fabXlabs/fabX_compactPCB/testAssemblyRender2.JPG

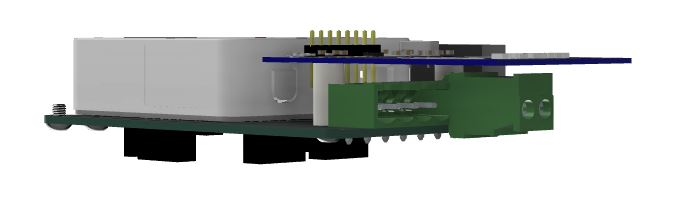
testAssemblyRender2.JPG
