fabXlabs/fabX_compactPCB/testAssemblyRender3.JPG

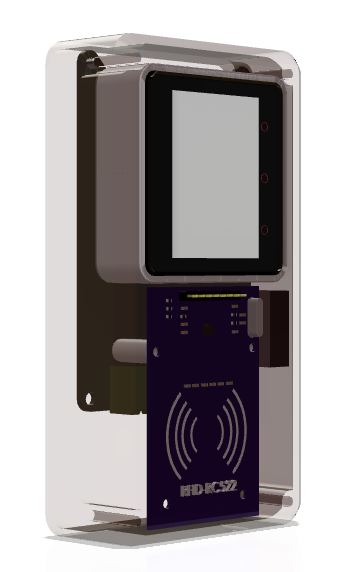
testAssemblyRender3.JPG
