fabXlabs/fabX_compactPCB/README.md

# fabX_compactPCB
Compact PCB (M5+CardReader+3xIO) for many simple Tasks
