fabXlabs/fabX_compactPCB/2022-10-31_bot2.JPG

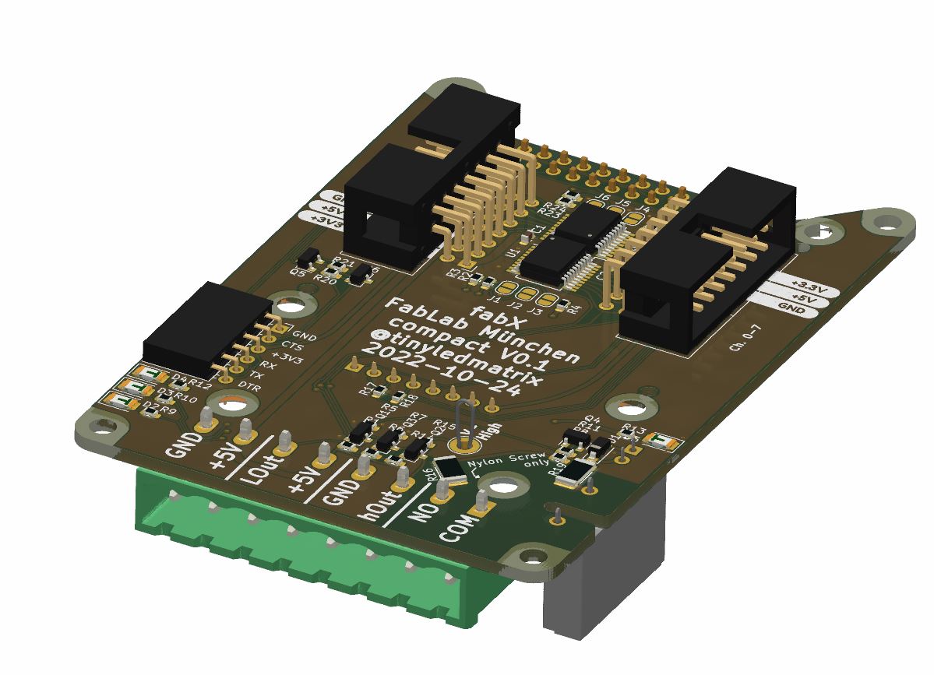
2022-10-31_bot2.JPG
