fabXlabs/fabX_compactPCB/2022-10-31_bot.JPG

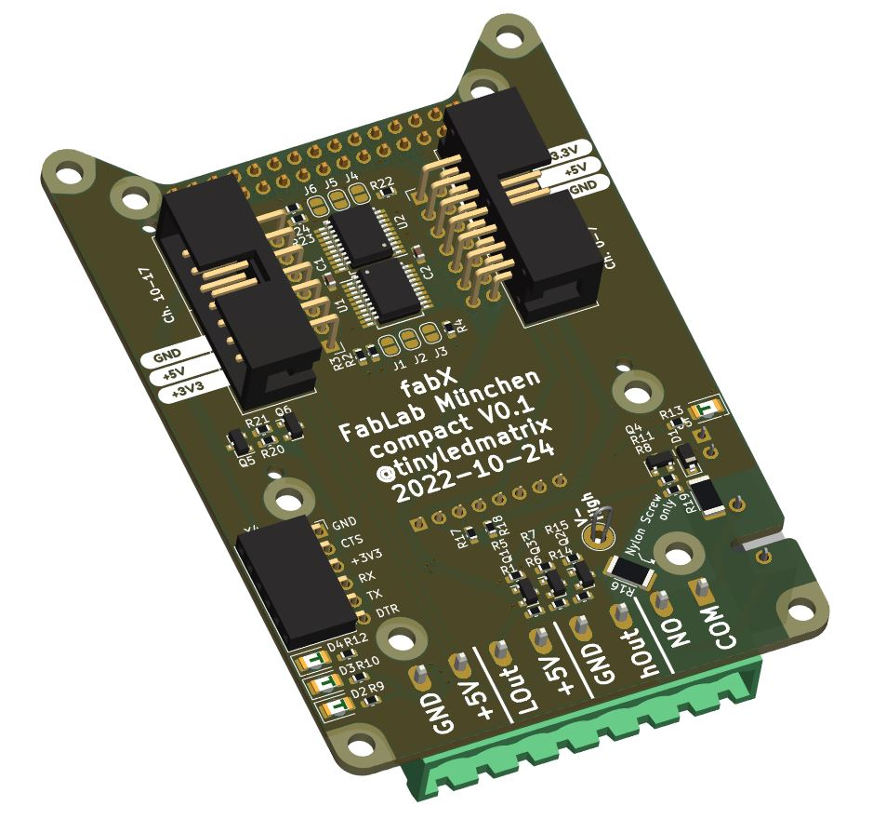
2022-10-31_bot.JPG
