fabXlabs/fabX_compactPCB/2022-10-31_top.JPG

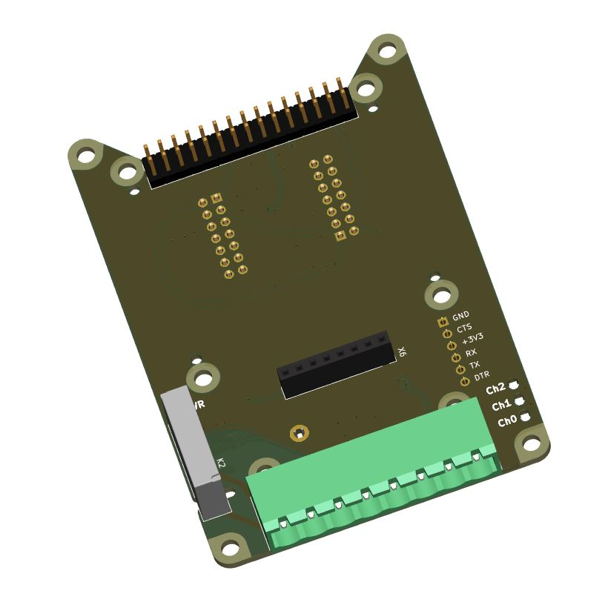
2022-10-31_top.JPG
