fabXlabs/fabX_compactPCB/KiCad_Project/BOM_fabX_cleaned.ods

Source: |  | D:\GitHub\fabX_compactPCB\KiCad_Project\fabX_compact.kicad_sch
Date: |  | 10/31/2022 6:27:46 PM
Tool: |  | Eeschema (6.0.6)
Generator: |  | C:\Program Files\KiCad\5.99\bin\scripting\plugins/bom_csv_grouped_by_value.py
Component Count: |  | 60
Individual Components:
Item | Qty | Reference(s) | Value | Footprint | Datasheet | Farnell# | Mnf | Mnf#
 |  | C1 | 100n 6v3 X7R | Capacitor_SMD:C_0603_1608Metric |  | 3345771 | Vishay | VJ0603Y104KXXPW1BC
 |  | C2 | 100n 6v3 X7R | Capacitor_SMD:C_0603_1608Metric |  | 3345771 | Vishay | VJ0603Y104KXXPW1BC
 |  | D1 | D | Diode_SMD:D_ | ~ | 2760409 | Nexperia | PMEG3020EGWX
 |  | D2 | LED | ownLEDs:LED_1206_3216Metric_ReverseMount_Hole1.8x2.4mm_3DMOD | ~ | 2099257 | Kingbright | KPTR-3216SYCK
 |  | D3 | LED | ownLEDs:LED_1206_3216Metric_ReverseMount_Hole1.8x2.4mm_3DMOD | ~ | 2099257 | Kingbright | KPTR-3216SYCK
 |  | D4 | LED | ownLEDs:LED_1206_3216Metric_ReverseMount_Hole1.8x2.4mm_3DMOD | ~ | 2099257 | Kingbright | KPTR-3216SYCK
 |  | D5 | LED | ownLEDs:LED_1206_3216Metric_ReverseMount_Hole1.8x2.4mm_3DMOD | ~ | 2099257 | Kingbright | KPTR-3216SYCK
 |  | K2 | PCN-105D3MHZ | Relay_THT:Relay_SPST_TE_PCN-1xxD3MHZ | https://standexelectronics.com/de/produkte/ums-reed-relais/ | 4444930 | TE | PCN-105D3MHZ
 |  | Q1 | 2N7002 | Package_TO_SOT_SMD:SOT-23 | https://www.onsemi.com/pdf/datasheet/nds7002a-d.pdf | 3924478 | Nexperia | 2N7002HR
 |  | Q2 | DMP3056L-7 | Package_TO_SOT_SMD:SOT-23 | https://www.farnell.com/datasheets/2814426.pdf | 3127362 | Diodes | DMP3056L-7
 |  | Q3 | 2N7002 | Package_TO_SOT_SMD:SOT-23 | https://www.onsemi.com/pdf/datasheet/nds7002a-d.pdf | 3924478 | Nexperia | 2N7002HR
 |  | Q4 | 2N7002 | Package_TO_SOT_SMD:SOT-23 | https://www.onsemi.com/pdf/datasheet/nds7002a-d.pdf | 3924478 | Nexperia | 2N7002HR
 |  | Q5 | BCX19 | Package_TO_SOT_SMD:SOT-23 |  | 2317581 | onsemi | BCX19LT1G
 |  | Q6 | BCX19 | Package_TO_SOT_SMD:SOT-23 |  | 2317581 | onsemi | BCX19LT1G
 |  | R1 | 100k | Resistor_SMD:R_0603_1608Metric |  | 3495222 | Yageo | AC0603FR-07100KL
 |  | R2 | 10k | Resistor_SMD:R_0603_1608Metric | ~ | 3495224 | Yageo | AC0603FR-0710KL
 |  | R3 | 10k | Resistor_SMD:R_0603_1608Metric | ~ | 3495224 | Yageo | AC0603FR-0710KL
 |  | R4 | 10k | Resistor_SMD:R_0603_1608Metric | ~ | 3495224 | Yageo | AC0603FR-0710KL
 |  | R5 | 10k | Resistor_SMD:R_0603_1608Metric | ~ | 3495224 | Yageo | AC0603FR-0710KL
 |  | R6 | 10k | Resistor_SMD:R_0603_1608Metric |  | 3495224 | Yageo | AC0603FR-0710KL
 |  | R7 | 10k | Resistor_SMD:R_0603_1608Metric | ~ | 3495224 | Yageo | AC0603FR-0710KL
 |  | R8 | 100k | Resistor_SMD:R_0603_1608Metric |  | 3495222 | Yageo | AC0603FR-07100KL
 |  | R9 | 1k | Resistor_SMD:R_0603_1608Metric |  | 3495238 | Yageo | AC0603FR-071KL
 |  | R10 | 1k | Resistor_SMD:R_0603_1608Metric |  | 3495238 | Yageo | AC0603FR-071KL
 |  | R11 | 10k | Resistor_SMD:R_0603_1608Metric | ~ | 3495224 | Yageo | AC0603FR-0710KL
 |  | R12 | 1k | Resistor_SMD:R_0603_1608Metric |  | 3495238 | Yageo | AC0603FR-071KL
 |  | R13 | 1k | Resistor_SMD:R_0603_1608Metric |  | 3495238 | Yageo | AC0603FR-071KL
 |  | R14 | 0R | Resistor_SMD:R_0603_1608Metric |  | 2309106 | Yageo | RC0603FR-070RL
 |  | R17 | 330 | Resistor_SMD:R_0603_1608Metric |  | 3950907 | Yageo | AC0603FR-07330RL
 |  | R18 | 330 | Resistor_SMD:R_0603_1608Metric |  | 3950907 | Yageo | AC0603FR-07330RL
 |  | R20 | 10k | Resistor_SMD:R_0603_1608Metric |  | 3495224 | Yageo | AC0603FR-0710KL
 |  | R21 | 10k | Resistor_SMD:R_0603_1608Metric |  | 3495224 | Yageo | AC0603FR-0710KL
 |  | R22 | 10k | Resistor_SMD:R_0603_1608Metric | ~ | 3495224 | Yageo | AC0603FR-0710KL
 |  | R23 | 10k | Resistor_SMD:R_0603_1608Metric | ~ | 3495224 | Yageo | AC0603FR-0710KL
 |  | R24 | 10k | Resistor_SMD:R_0603_1608Metric | ~ | 3495224 | Yageo | AC0603FR-0710KL
 |  | U1 | MCP23008 | Package_SO:SSOP-20_5.3x7.2mm_P0.65mm | https://ww1.microchip.com/downloads/en/DeviceDoc/21919e.pdf | 1605564 | Microchip | MCP23008-E/SS
 |  | U2 | MCP23008 | Package_SO:SSOP-20_5.3x7.2mm_P0.65mm | https://ww1.microchip.com/downloads/en/DeviceDoc/21919e.pdf | 1605564 | Microchip | MCP23008-E/SS
 |  | X1 | Conn_02x15_Odd_Even | Connector_PinSocket_2.54mm:PinSocket_2x15_P2.54mm_Vertical |  | - | MISC/VORRAT | testen mit Prototyp wegen hÃ¶he
 |  | X2 | Screw_Terminal_01x08 | Connector_Phoenix_MSTB:PhoenixContact_MSTBA_2,5_8-G-5,08_1x08_P5.08mm_Horizontal | ~ | 2671266 | Phoenix | MSTB 2,5/ 8-G-5,08
 |  | X3 | Conn_02x07_Odd_Even | Connector_IDC:IDC-Header_2x07_P2.54mm_Horizontal | https://www.we-online.com/katalog/datasheet/61201421721.pdf | 2356264 | Wuerth | 61201421721
 |  | X4 | Conn_01x06 | Connector_PinSocket_2.54mm:PinSocket_1x06_P2.54mm_Horizontal |  | 2084276 | GCT | BG302-06-A-L-G
 |  | X5 | Conn_02x07_Odd_Even | Connector_IDC:IDC-Header_2x07_P2.54mm_Horizontal | https://www.we-online.com/katalog/datasheet/61201421721.pdf | 2356264 | Wuerth | 61201421721
 |  | X6 | Conn_01x08 | Connector_PinSocket_2.54mm:PinSocket_1x08_P2.54mm_Vertical |  | - | MISC/VORRAT | testen mit Prototyp wegen hÃ¶he
Collated Components:
Item | Qty | Reference(s) | Value | Footprint | Datasheet | Farnell# | Mnf | Mnf#
1 | 2 | C1, C2 | 100n 6v3 X7R | Capacitor_SMD:C_0603_1608Metric |  | 3345771 | Vishay | VJ0603Y104KXXPW1BC
2 | 1 | D1 | D | Diode_SMD:D_ | ~ | 2760409 | Nexperia | PMEG3020EGWX
3 | 4 | D2, D3, D4, D5 | LED | ownLEDs:LED_1206_3216Metric_ReverseMount_Hole1.8x2.4mm_3DMOD | ~ | 2099257 | Kingbright | KPTR-3216SYCK
8 | 1 | K2 | PCN-105D3MHZ | Relay_THT:Relay_SPST_TE_PCN-1xxD3MHZ | https://standexelectronics.com/de/produkte/ums-reed-relais/ | 4444930 | TE | PCN-105D3MHZ
9 | 3 | Q1, Q3, Q4 | 2N7002 | Package_TO_SOT_SMD:SOT-23 | https://www.onsemi.com/pdf/datasheet/nds7002a-d.pdf | 3924478 | Nexperia | 2N7002HR
10 | 1 | Q2 | DMP3056L-7 | Package_TO_SOT_SMD:SOT-23 | https://www.farnell.com/datasheets/2814426.pdf | 3127362 | Diodes | DMP3056L-7
11 | 2 | Q5, Q6 | BCX19 | Package_TO_SOT_SMD:SOT-23 |  | 2317581 | onsemi | BCX19LT1G
12 | 2 | R1, R8 | 100k | Resistor_SMD:R_0603_1608Metric |  | 3495222 | Yageo | AC0603FR-07100KL
13 | 9 | R2, R3, R4, R5, R7, R11, R22, R23, R24 | 10k | Resistor_SMD:R_0603_1608Metric | ~ | 3495224 | Yageo | AC0603FR-0710KL
14 | 3 | R6, R20, R21 | 10k | Resistor_SMD:R_0603_1608Metric |  | 3495224 | Yageo | AC0603FR-0710KL
15 | 4 | R9, R10, R12, R13 | 1k | Resistor_SMD:R_0603_1608Metric |  | 3495238 | Yageo | AC0603FR-071KL
16 | 1 | R14 | 0R | Resistor_SMD:R_0603_1608Metric |  | 2309106 | Yageo | RC0603FR-070RL
17 | 2 | R17, R18 | 330 | Resistor_SMD:R_0603_1608Metric |  | 3950907 | Yageo | AC0603FR-07330RL
18 | 2 | U1, U2 | MCP23008 | Package_SO:SSOP-20_5.3x7.2mm_P0.65mm | https://ww1.microchip.com/downloads/en/DeviceDoc/21919e.pdf | 1605564 | Microchip | MCP23008-E/SS
20 | 1 | X1 | Conn_02x15_Odd_Even | Connector_PinSocket_2.54mm:PinSocket_2x15_P2.54mm_Vertical |  | - | MISC/VORRAT | testen mit Prototyp wegen hÃ¶he
21 | 1 | X2 | Screw_Terminal_01x08 | Connector_Phoenix_MSTB:PhoenixContact_MSTBA_2,5_8-G-5,08_1x08_P5.08mm_Horizontal | ~ | 2671266 | Phoenix | MSTB 2,5/ 8-G-5,08
22 | 2 | X3, X5 | Conn_02x07_Odd_Even | Connector_IDC:IDC-Header_2x07_P2.54mm_Horizontal | https://www.we-online.com/katalog/datasheet/61201421721.pdf | 2356264 | Wuerth | 61201421721
23 | 1 | X4 | Conn_01x06 | Connector_PinSocket_2.54mm:PinSocket_1x06_P2.54mm_Horizontal |  | 2084276 | GCT | BG302-06-A-L-G
24 | 1 | X6 | Conn_01x08 | Connector_PinSocket_2.54mm:PinSocket_1x08_P2.54mm_Vertical |  | - | MISC/VORRAT | testen mit Prototyp wegen hÃ¶he
