fabXlabs/fabX_compactPCB/KiCad_Project/outline.dxf

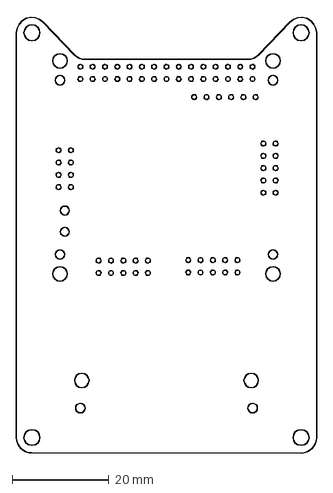
[picture p6: CAD file, 2022-09-20]
KiCad_Project/outline.dxf
62.0 x 90.3 mm
