fabXlabs/fabX_compactPCB/KiCad_Project/fabX_compact.kicad_pcb

## KiCad design KiCad_Project/fabX_compact.kicad_pcb (2024-01-02)

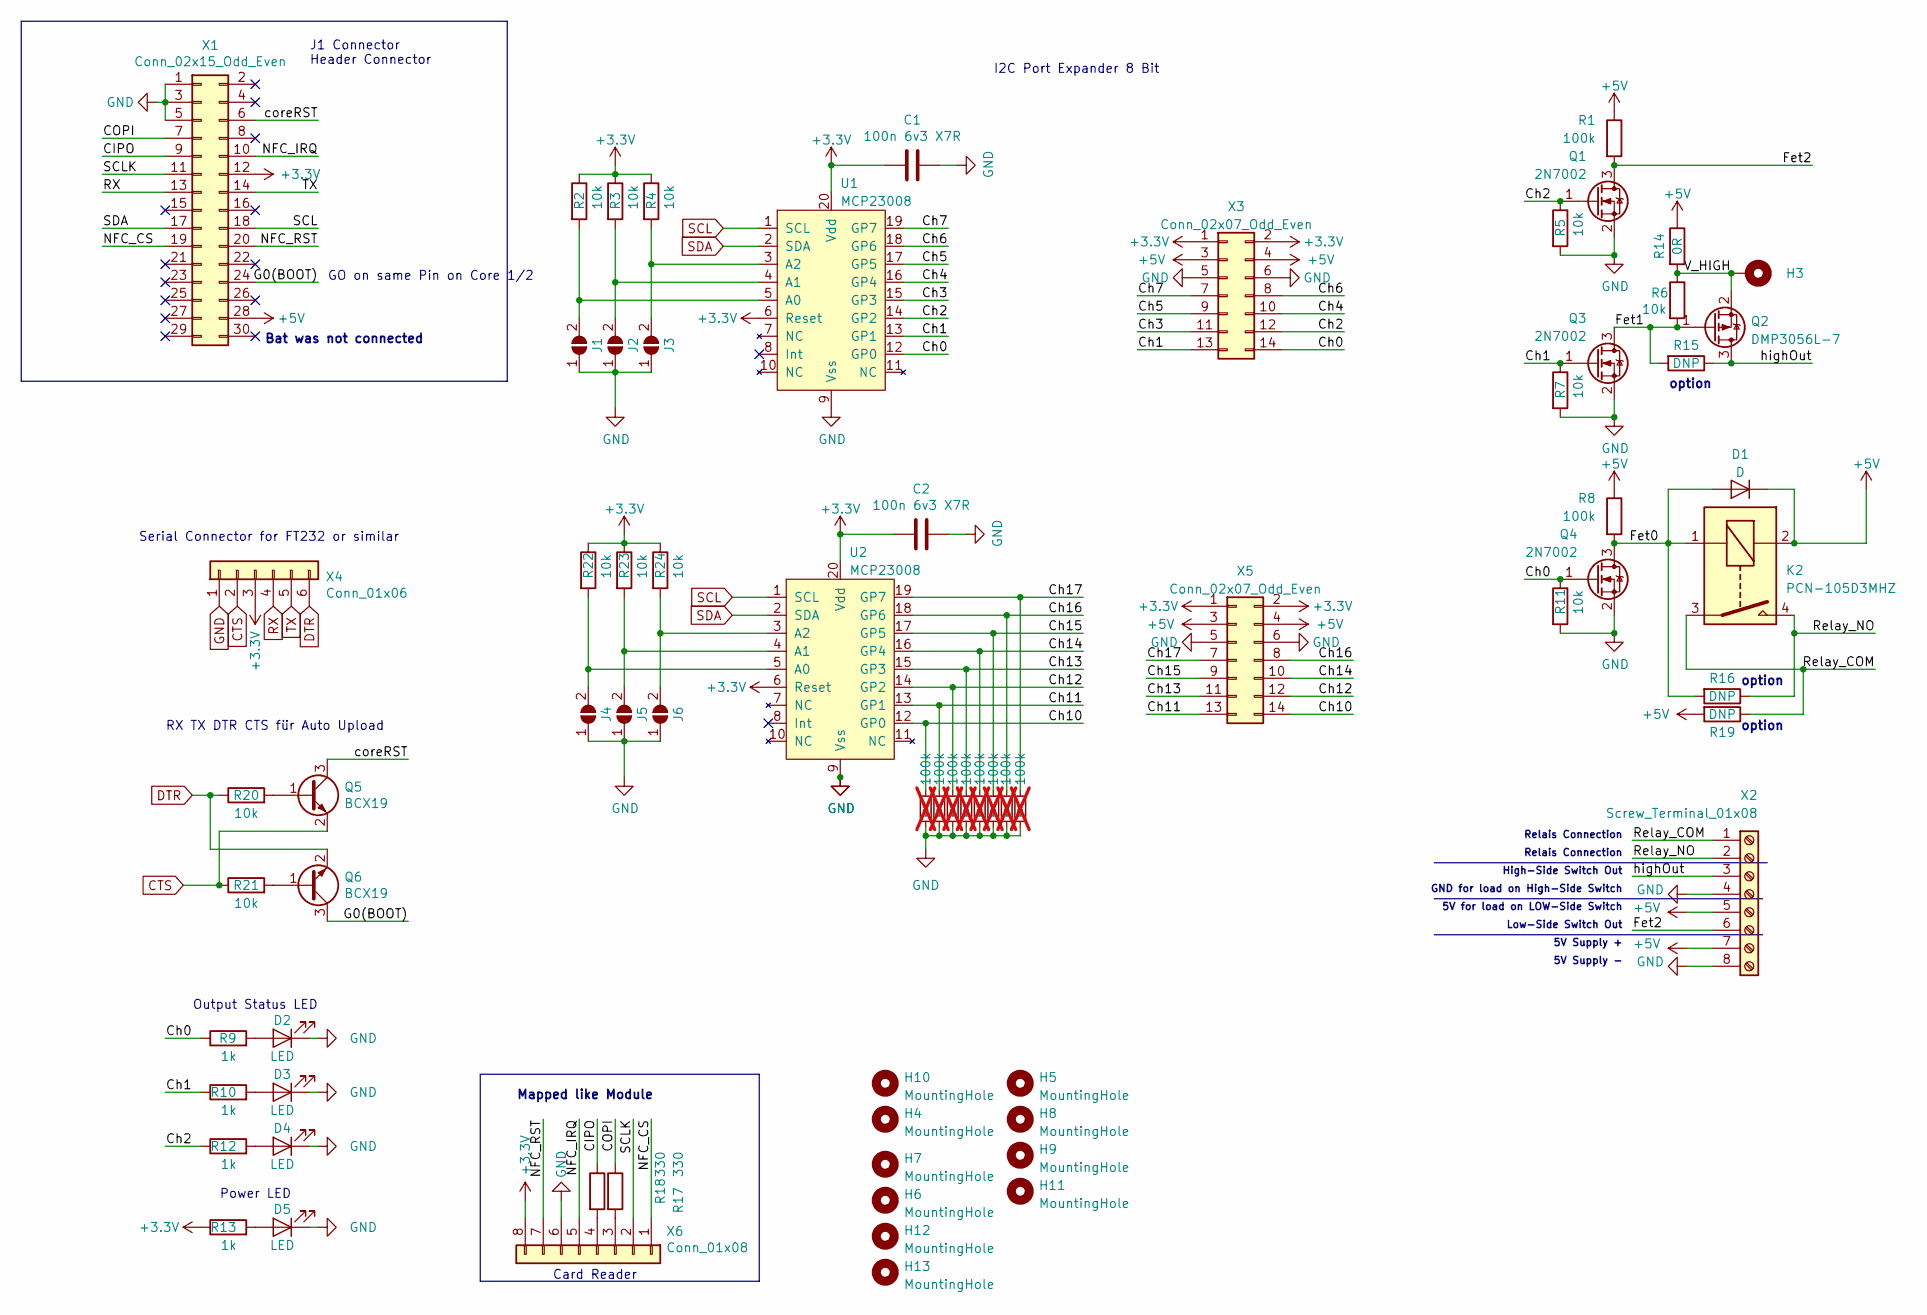
[picture p7: schematic fabX_compact.kicad_sch]

Parts:
C1, C2: 100n 6v3 X7R; C_0603_1608Metric; Farnell# 3345771
D1: D; D_; Farnell# 2760409
D2, D3, D4, D5: LED; LED_1206_3216Metric_ReverseMount_Hole1.8x2.4mm_3DMOD; Farnell# 2099257
H3: MountingHole_Pad; TestPoint_Loop_D2.50mm_Drill1.85mm
H4, H6, H7, H10, H12, H13: MountingHole; MountingHole_3.2mm_M3_noSolder
H5, H8, H9, H11: MountingHole; MountingHole_3.2mm_M3_noSolderCorner
J1, J2, J3, J4, J5, J6: SolderJumper_2_Open; SolderJumper-2_P1.3mm_Open_RoundedPad1.0x1.5mm
K2: PCN-105D3MHZ; Relay_SPST_TE_PCN-1xxD3MHZ; Farnell# 4444930
Q1, Q3, Q4: 2N7002; SOT-23; Farnell# 3924478
Q2: DMP3056L-7; SOT-23; Farnell# 3127362
Q5, Q6: BCX19; SOT-23; Farnell# 2317581
R1, R8: 100k; R_0603_1608Metric; Farnell# 3495222
R2, R3, R4, R5, R6, R7, R11, R20, R21, R22, R23, R24: 10k; R_0603_1608Metric; Farnell# 3495224
R9, R10, R12, R13: 1k; R_0603_1608Metric; Farnell# 3495238
R14: 0R; R_0603_1608Metric; Farnell# 2309106
R15: DNP; R_0603_1608Metric
R16, R19: DNP; R_2010_5025Metric
R17, R18: 330; R_0603_1608Metric; Farnell# 3950907
R25, R26, R27, R28, R29, R30, R31, R32: 100k; R_0603_1608Metric; not fitted
U1, U2: MCP23008; SSOP-20_5.3x7.2mm_P0.65mm; Farnell# 1605564
X1: Conn_02x15_Odd_Even; PinSocket_2x15_P2.54mm_Vertical
X2: Screw_Terminal_01x08; PhoenixContact_MSTBA_2,5_8-G-5,08_1x08_P5.08mm_Horizontal; Farnell# 2671266
X3, X5: Conn_02x07_Odd_Even; IDC-Header_2x07_P2.54mm_Horizontal; Farnell# 2356264
X4: Conn_01x06; PinSocket_1x06_P2.54mm_Horizontal; Farnell# 2084276
X6: Conn_01x08; PinSocket_1x08_P2.54mm_Vertical

Connections:
+3V3: C1.2, C2.2, R2.1, R3.1, R4.1, R13.1, R22.1, R23.1, R24.1, U1.6 (Reset), U1.20 (Vdd), U2.6 (Reset), U2.20 (Vdd), X1.12, X3.1, X3.2, X4.3, X5.1, X5.2, X6.8
+5V: D1.1 (K), K2.2, R1.1, R8.1, R14.1, R19.2, X1.28, X2.5, X2.7, X3.3, X3.4, X5.3, X5.4
/CIPO: R18.1, X1.9
/COPI: R17.1, X1.7
/Ch0: Q4.1 (G), R9.1, R11.1, U1.12 (GP0), X3.14
/Ch1: Q3.1 (G), R7.1, R10.1, U1.13 (GP1), X3.13
/Ch2: Q1.1 (G), R5.1, R12.1, U1.14 (GP2), X3.12
/Ch3: U1.15 (GP3), X3.11
/Ch4: U1.16 (GP4), X3.10
/Ch5: U1.17 (GP5), X3.9
/Ch6: U1.18 (GP6), X3.8
/Ch7: U1.19 (GP7), X3.7
/Ch10: R25.1, U2.12 (GP0), X5.14
/Ch11: R26.1, U2.13 (GP1), X5.13
/Ch12: R27.1, U2.14 (GP2), X5.12
/Ch13: R28.1, U2.15 (GP3), X5.11
/Ch14: R29.1, U2.16 (GP4), X5.10
/Ch15: R30.1, U2.17 (GP5), X5.9
/Ch16: R31.1, U2.18 (GP6), X5.8
/Ch17: R32.1, U2.19 (GP7), X5.7
/Fet0: D1.2 (A), K2.1, Q4.3 (D), R8.2, R16.2
/Fet1: Q2.1 (G), Q3.3 (D), R6.2, R15.2
/Fet2: Q1.3 (D), R1.2, X2.6
/G0(BOOT): Q6.3 (C), X1.24
/NFC_CS: X1.19, X6.1
/NFC_IRQ: X1.10, X6.5
/NFC_RST: X1.20, X6.7
/Relay_COM: K2.3, R19.1, X2.1
/Relay_NO: K2.4, R16.1, X2.2
/SCLK: X1.11, X6.2
/V_HIGH: H3.1, Q2.2 (S), R6.1, R14.2
/coreRST: Q5.3 (C), X1.6
/highOut: Q2.3 (D), R15.1, X2.3
CTS: Q5.2 (E), R21.1, X4.2
DTR: Q6.2 (E), R20.1, X4.6
GND: C1.1, C2.1, D2.1 (K), D3.1 (K), D4.1 (K), D5.1 (K), J1.1 (A), J2.1 (A), J3.1 (A), J4.1 (A), J5.1 (A), J6.1 (A), Q1.2 (S), Q3.2 (S), Q4.2 (S), R5.2, R7.2, R11.2, R25.2, R26.2, R27.2, R28.2, R29.2, R30.2, R31.2, R32.2, U1.9 (Vss), U2.9 (Vss), X1.1, X1.3, X1.5, X2.4, X2.8, X3.5, X3.6, X4.1, X5.5, X5.6, X6.6
unnamed: D2.2 (A), R9.2
unnamed: D3.2 (A), R10.2
unnamed: D4.2 (A), R12.2
unnamed: D5.2 (A), R13.2
unnamed: J1.2 (B), R2.2, U1.5 (A0)
unnamed: J2.2 (B), R3.2, U1.4 (A1)
unnamed: J3.2 (B), R4.2, U1.3 (A2)
unnamed: J4.2 (B), R22.2, U2.5 (A0)
unnamed: J5.2 (B), R23.2, U2.4 (A1)
unnamed: J6.2 (B), R24.2, U2.3 (A2)
unnamed: Q5.1 (B), R20.2
unnamed: Q6.1 (B), R21.2
unnamed: R17.2, X6.3
unnamed: R18.2, X6.4
RX: X1.13, X4.4
SCL: U1.1 (SCL), U2.1 (SCL), X1.18
SDA: U1.2 (SDA), U2.2 (SDA), X1.17
TX: X1.14, X4.5

Notes on the sheet:
Card Reader
GND for load on High-Side Switch
GO on same Pin on Core 1/2
Relais Connection
High-Side Switch Out
RX TX DTR CTS für Auto Upload
option
5V Supply -
Low-Side Switch Out
Bat was not connected
5V Supply +
Serial Connector for FT232 or similar
J1 Connector Header Connector
Output Status LED
Mapped like Module
5V for load on LOW-Side Switch
I2C Port Expander 8 Bit
Power LED

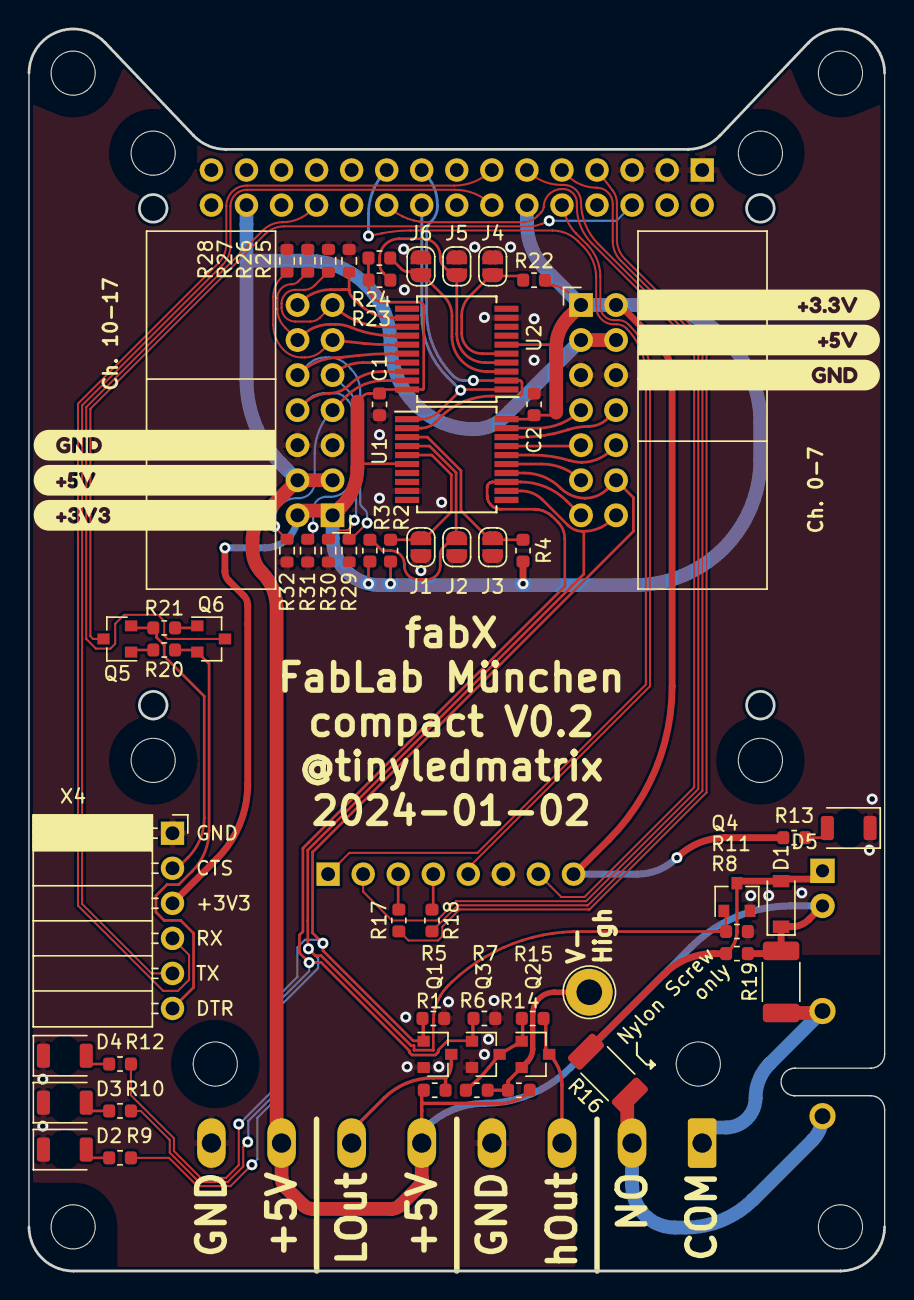
[picture p8: board fabX_compact.kicad_pcb from above]

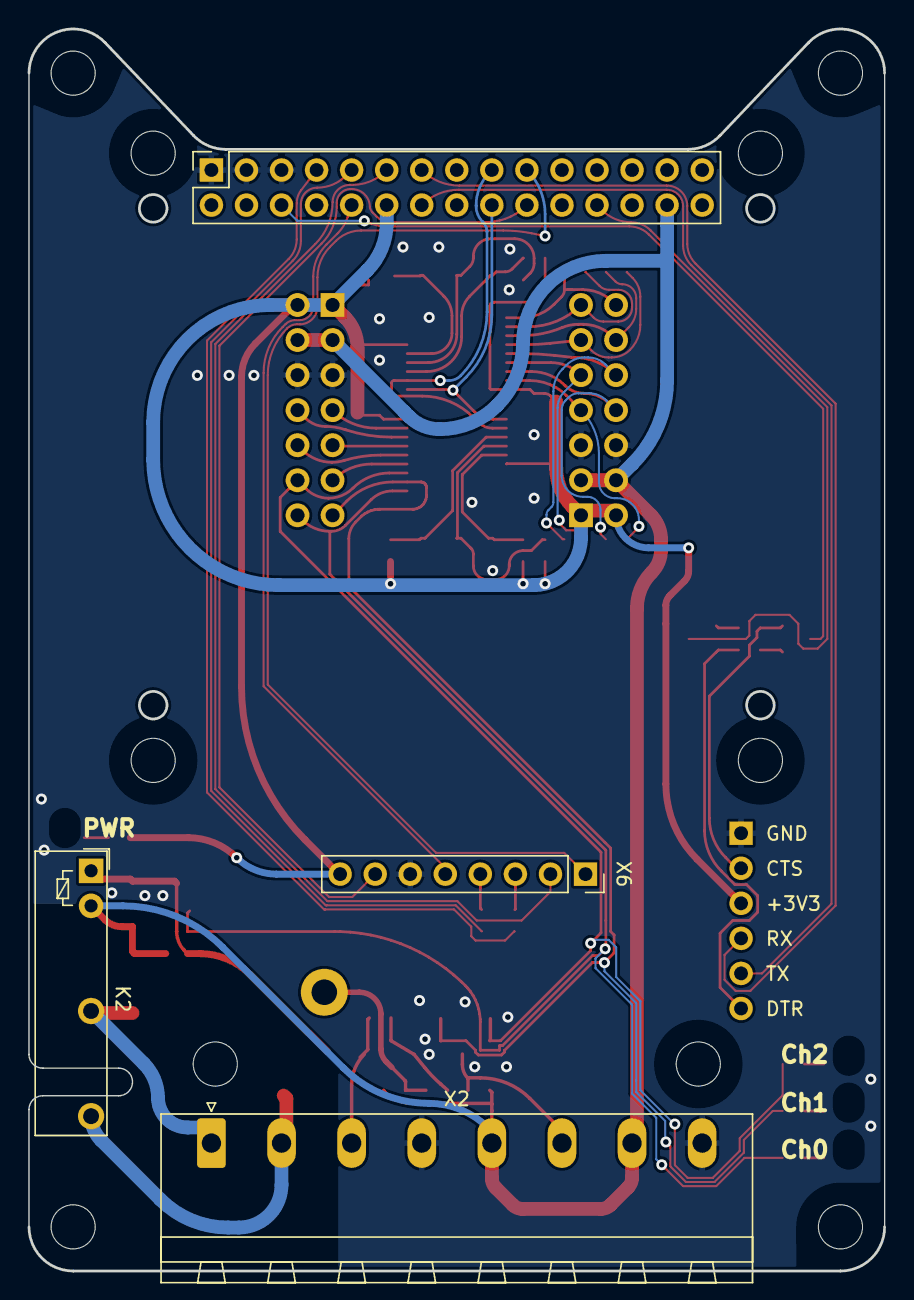
[picture p9: board fabX_compact.kicad_pcb from below]

Board: 2 copper layers, 62.0 x 90.0 mm, 77 parts (4 on the bottom side), 54 nets.

Other parts of the board:
kibuzzard-632A457B: G***; kibuzzard-632A457B
kibuzzard-632A4549: G***; kibuzzard-632A4549
kibuzzard-632A4565: G***; kibuzzard-632A4565
kibuzzard-635FD36E: G***; kibuzzard-635FD36E
kibuzzard-635FD364: G***; kibuzzard-635FD364
kibuzzard-635FD378: G***; kibuzzard-635FD378
