fabXlabs/fabX_compactPCB/testAssemblyRender1.JPG

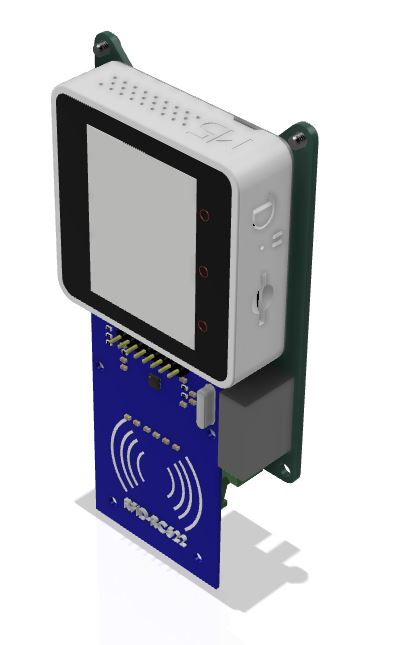
testAssemblyRender1.JPG
