fabXlabs/fabX_compactPCB/(commit log)

2022-09-20 Initial kicad Push
    Still much TODO but could get seen by a second pair of eyes
    [fabX_compact.kicad_pcb, fabX_compact.kicad_sch, outline.dxf]
2022-09-20 Added some MCAD Screenshots for assembly/case idea
2022-09-26 some PCB progress
    [fabX_compact.kicad_pcb, fabX_compact.kicad_sch]
2022-10-31 PCB progress
    [fabX_compact.kicad_pcb, fabX_compact.kicad_sch]
2022-10-31 added bom
    [BOM_fabX_cleaned.ods, fabX_compact.kicad_pcb, fabX_compact.kicad_sch]
2023-12-29 add pulldowns for inputs
    [fabX_compact.kicad_sch]
2024-01-02 new PCB Version V0.2
    Added new Pulddown Rs to PCB
    DRC okay
    [fabX_compact.kicad_pcb, fabX_compact.kicad_sch]
